zyrvad/digicam/README.md

# Gift cameras (2 units, for friends)

Two DIY retro digital cameras, built as gifts, on shared electronics and firmware:

1. **InstantSnap.novo-style** flat body with a 1.69 in screen. Due 31 Oct 2026 (assumed) and built first.
2. **Yashica Mini Snoopy-style** box with a bigger 2.8 in screen. Follows after; date to confirm.

This is a separate project from `../PLAN.md`. That file (July 2026) plans a screenless, disposable-style camera as a commercial product.

## Files

| File | What it is |
| --- | --- |
| `01-research-brief.md` | First research pass: commercial cameras compared, buy vs build, early hardware ideas |
| `02-build-plan.md` | **The current plan**: decisions, 4-week timeline, parts, wiring and charging, pin plan, firmware spec, case finish, checklists |
| `03-how-it-works.md` | How the firmware and simulator work, step by step |
| `04-case-design.md` | Camera 1 case. **v2 test-fit body (10 Oct)** first: electronics sled, layout, wiring lanes, hardware, assembly, printing, what to measure. Then the v1 concept |
| `08-phone-app-plan.md` | Getting photos onto an iPhone: **Phone mode** (camera Wi-Fi, a photo page in Safari, a free Shortcut for saving many), built 15 Oct. Then the earlier app plan |
| `11-assembly-guide-v3.md` | **Build either v3 body (23 Oct)**, with an interactive 3D version at https://claude.ai/artifact/BogmuenUrWaN1Fk98t3Pgy (`guide-v3/`): tools and parts, heat-set inserts, the wiring diagram (part pin to board pad), wire routes and cut lengths, soldering, ten build steps with pictures, what holds each part, checks and fixes |
| `13-assembly-guide-v4.md` | **Build camera 1 (v4, 24 Oct)**: the retro body rebuilt around the real screen and board, styled after the Leica M6 in brown and in its proportions (128 × 73 × 22 mm, 25 Oct). What to measure before printing, the three Bambu plates (a test-first plate of the inside), screws and inserts, the v4 pin plan and wire lengths, build steps. Model `cad/camera1_v4.scad`, exports `cad/export/v4/` |
| `12-packing-list-retro.md` | **Packing list for building the retro camera (24 Oct)**: what to do before leaving, all 20 printed pieces, electronics, screws and inserts by length, wire/tape/glue, tools, cables, offline guides |
| `10-frame-mailbox.md` | **DigiGallery frame mailbox (22 Oct)**: the phone page picks what Allen's desk frame shows; `/api/frame` on the camera, the document's format, tests |
| `09-phone-ui-design.md` | **Phone page v2 plan (21 Oct)**: design, mockup in `design/phone-v2/`, the home-screen app evaluated, firmware changes it needs |
| `07-shopping-list.md` | What's still to buy to join the parts: battery socket, camera ribbon, wire, inserts, screws, tape, with Lazada search terms |
| `06-assembly-guide.md` | **Step-by-step assembly with a picture per step**, and the link to the interactive 3D guide (`guide/`) |
| `05-bench-bring-up.md` | **Start here with the parts on the desk**: wiring every part to the board, testing the whole pipeline step by step, and removing the pin headers for the case |
| `cad/` | **v4 (24 Oct): `camera1_v4.scad`**, retro only, built around the measured parts (`export_v4.py`, `check_v4.py`, `make_plates_v4.py`, `wiring_v4.py`). Before that, **v3 bodies (23 Oct): `camera1_v3.scad`**, two styles (clear Novo-like and retro rangefinder) for the 2.0 in screen and the camera on the board. Print files in `export/v3/<style>/`, renders in `renders/v3/`, `export_v3.py` rebuilds and runs the fit check `check_v3.py`. Older: v2 (`camera1_v2.scad`, 1.14 in screen), v1 Fusion model |
| `firmware/` | ESP-IDF camera firmware (0.4.3): runs the camera on its own with screen, buttons and battery gauge; preview, photos, video, gallery, settings, film looks, and Phone mode (its own Wi-Fi and photo page) |
| `host/` | Laptop simulator: a virtual camera in the browser driving the real board. Start with `host/run.sh` ([host/README.md](host/README.md)). `host/bench.py`: screenshots of the camera's screen, button presses, status and log from the terminal |
| `diagrams/` | `wiring-bench.png` (every wire, pin to pin; from `wiring_bench.py`), `timeline.png` and `wiring.png` (block diagram; still shows the dial), `wiring-early.png` (first sketch, superseded), rendered from the claude.ai doc |

**These local files are the main copy** (decided 8 Oct 2026). Edit them here. The claude.ai doc https://claude.ai/artifact/KfYH1emPw4jr6YSeR5GVqt is frozen as of 8 Oct and is no longer updated.

## Hardware at a glance

- Board: GOOUUU ESP32-S3-CAM Core N16R8 with OV3660, on a ribbon extension. You own one (camera 1); buy one more (camera 2).
- Screens: 1.69 in ST7789 IPS 240×280 (camera 1); 2.8 in ST7789 IPS 320×240 (camera 2). Controls: rotary dial (EC11), shutter button, slide switch.
- Power: 3.7 V LiPo (camera 1: the 2000 mAh 103450 you own) → USB-C charge + boost module (IP5306 type) → switch → board 5V pin.
- Storage: the board's built-in microSD slot (SDMMC 1-bit, GPIO 38/39/40).
- Firmware: `firmware/` (ESP-IDF v5.5.4); camera and SD code came from Love Letter Box's `firmware/camera-test` (now on its repo's `june-2026` branch). Since 10 Oct the camera runs standalone on the 1.14 in screen; `host/` still works alongside it.
