zyrvad/digicam/cad/art/leather.png

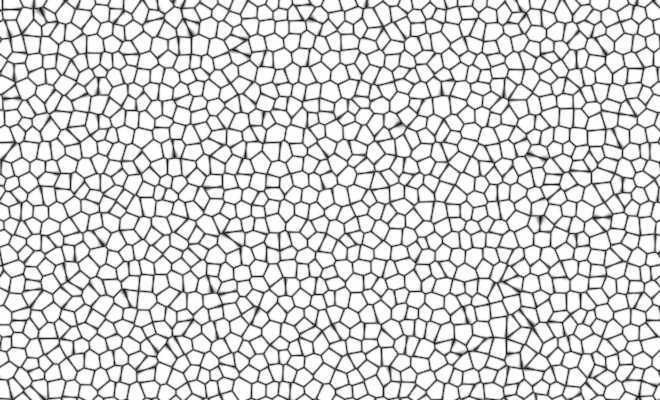
cad/art/leather.png
