zyrvad/digicam/cad/renders/v4/deck_screen_board.png

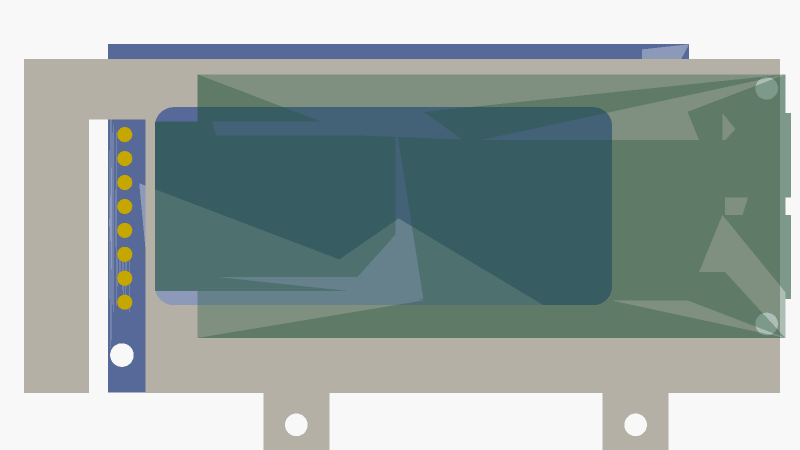
cad/renders/v4/deck_screen_board.png
