zyrvad/digicam/cad/renders/v4/exploded.png

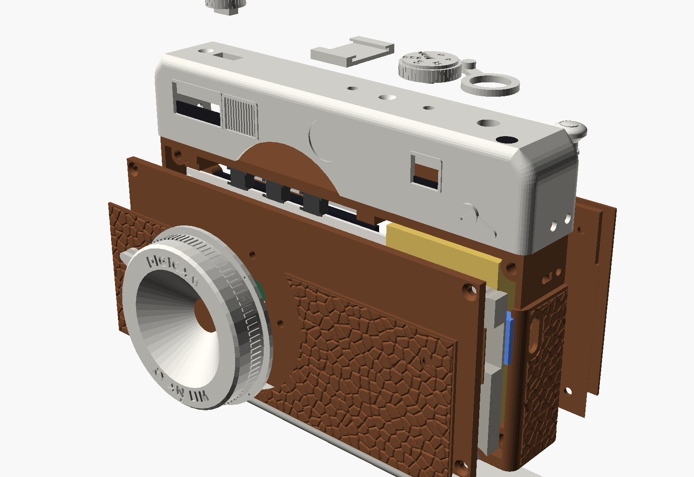
cad/renders/v4/exploded.png
