zyrvad/digicam/cad/renders/v4/front_flat.png

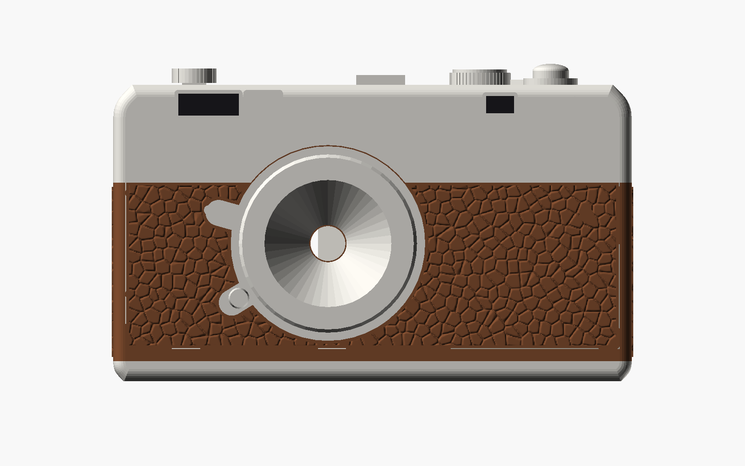
cad/renders/v4/front_flat.png
