zyrvad/digicam/cad/renders/v4/inside.png

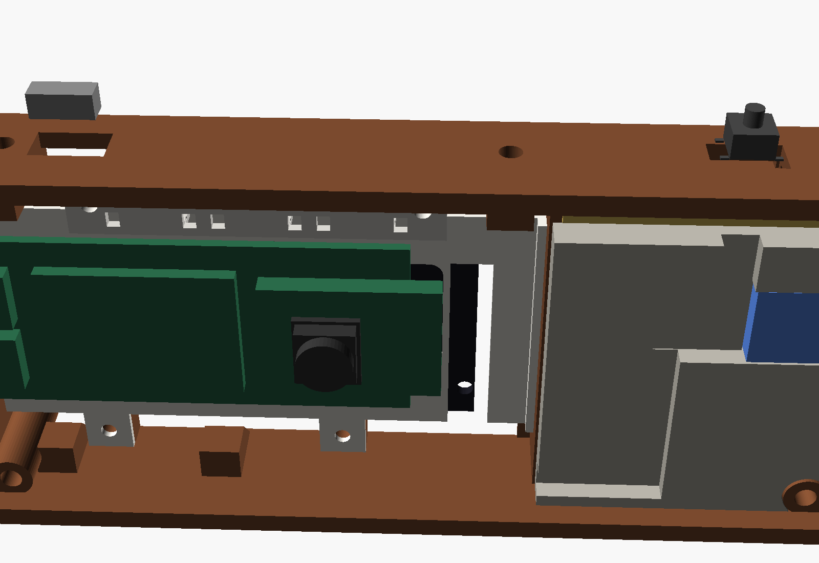
cad/renders/v4/inside.png
