zyrvad/digicam/cad/renders/v4/screen_bevel.png

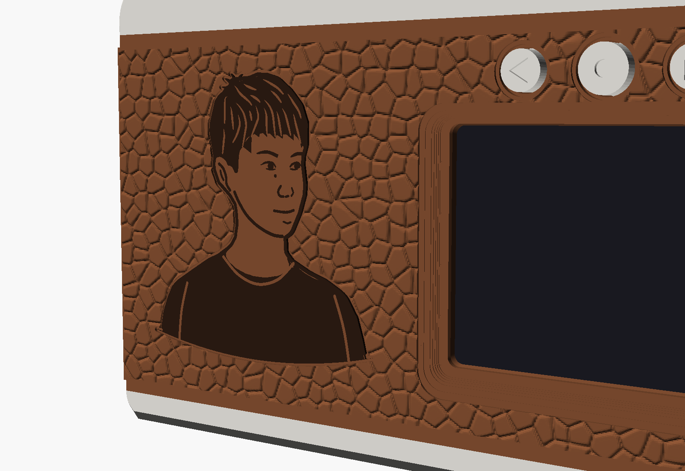
cad/renders/v4/screen_bevel.png
