zyrvad/digicam/cad/renders/v4/top_lefthanded.png

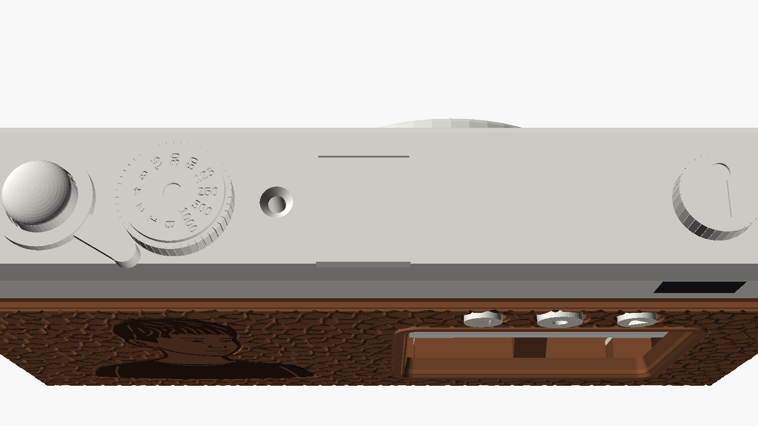
cad/renders/v4/top_lefthanded.png
