zyrvad/digicam/diagrams/stack-v4.png

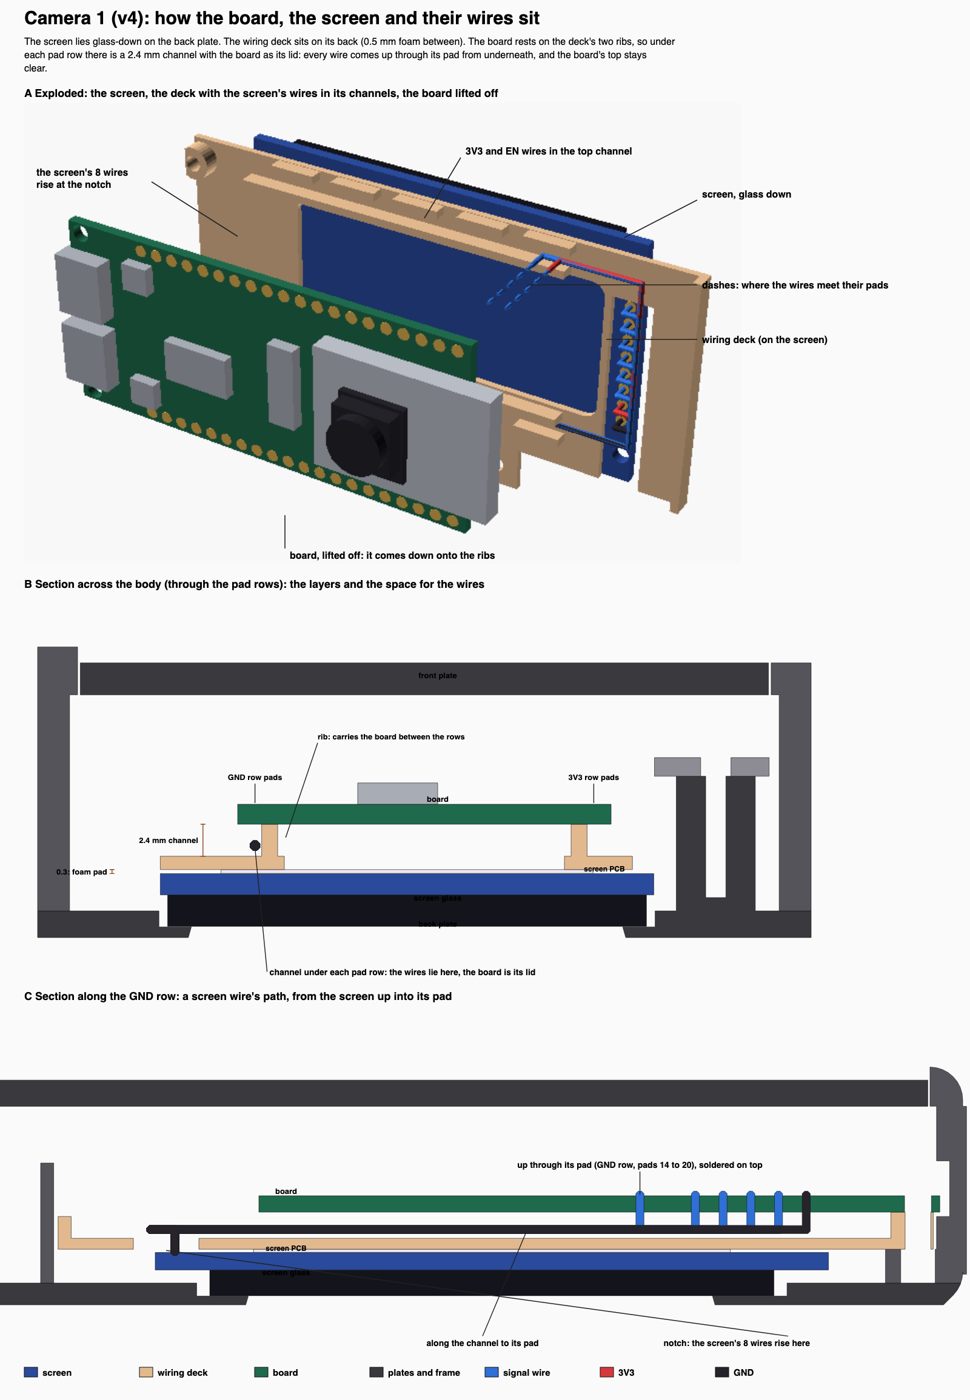
diagrams/stack-v4.png
