zyrvad/digicam/cad/export/v4/back_leatherette.3mf

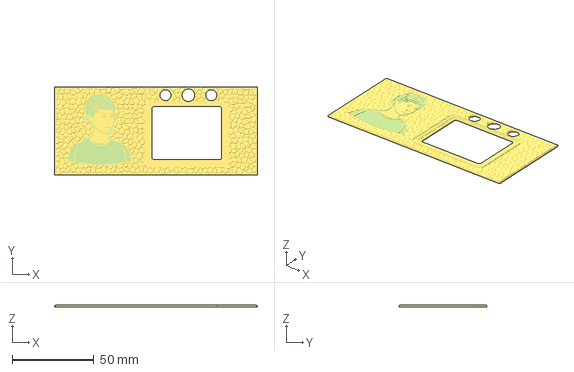
[picture p9: CAD file, 2026-10-27]
cad/export/v4/back_leatherette.3mf
124.0 x 54.0 x 1.40 mm
