zyrvad/digicam/cad/export/v4/frame.3mf

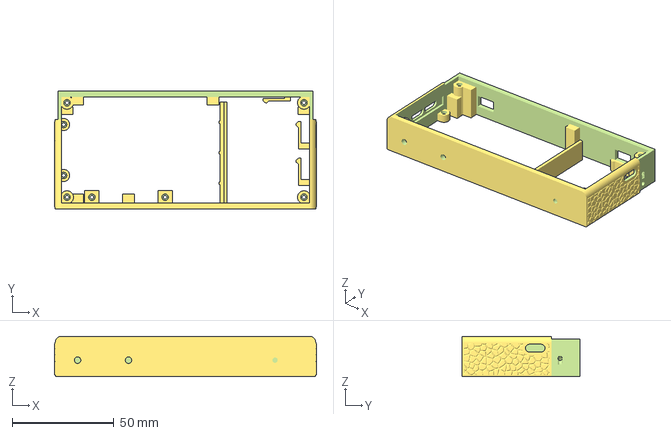
[picture p10: CAD file, 2026-10-27]
cad/export/v4/frame.3mf
128.7 x 58.0 x 19.8 mm
