zyrvad/digicam/cad/export/v4/portrait_inlay.3mf

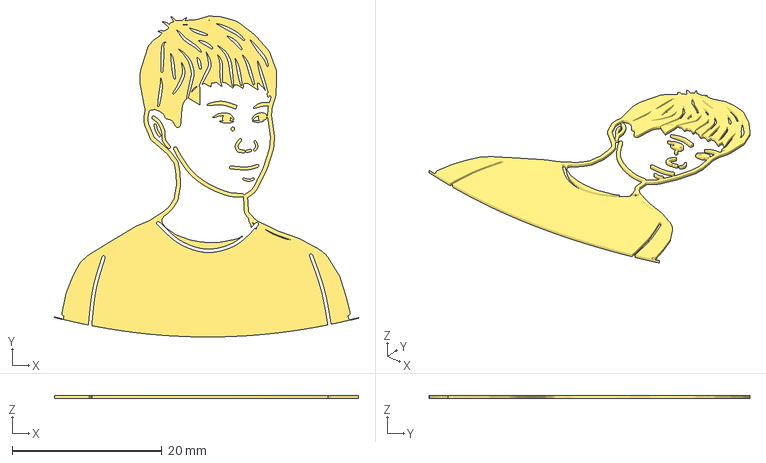
[picture p11: CAD file, 2026-10-27]
cad/export/v4/portrait_inlay.3mf
40.6 x 42.9 x 0.4 mm
