zyrvad/digicam/cad/export/v4/lens_barrel.stl

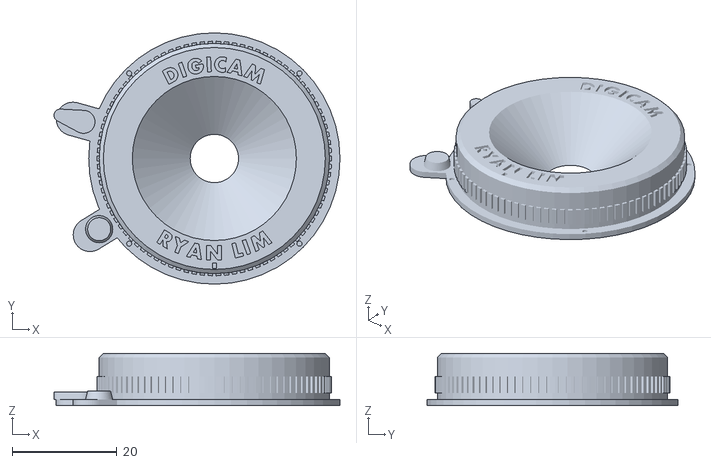
[picture p12: CAD file, 2026-10-27]
cad/export/v4/lens_barrel.stl
54.6 x 48.0 x 9.99
