zyrvad/digicam/cad/export/v4/window_card.stl

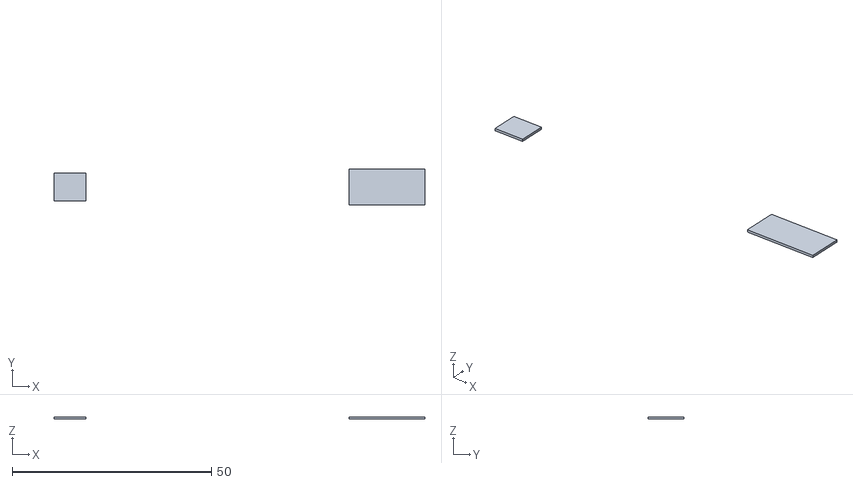
[picture p13: CAD file, 2026-10-27]
cad/export/v4/window_card.stl
93.0 x 9.00 x 0.6
