zyrvad/digicam/cad/export/v4/bottom_plate.stl

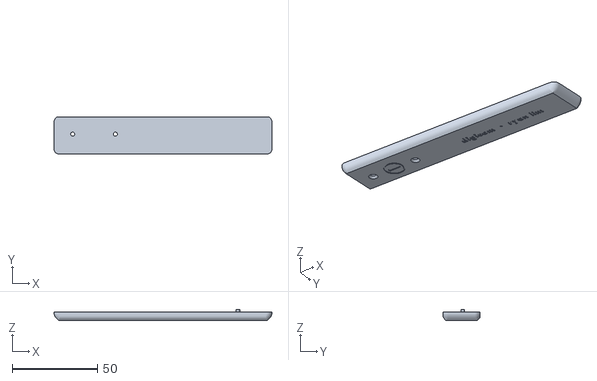
[picture p14: CAD file, 2026-10-27]
cad/export/v4/bottom_plate.stl
128.0 x 21.8 x 6.39
