zyrvad/digicam/cad/export/v4/leatherette.3mf

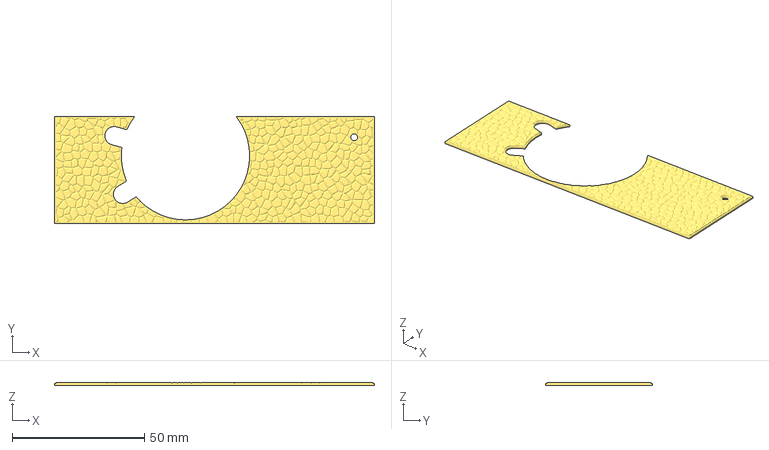
[picture p15: CAD file, 2026-10-27]
cad/export/v4/leatherette.3mf
121.2 x 40.4 x 1.20 mm
