zyrvad/digicam/cad/export/v4/top_bits.stl

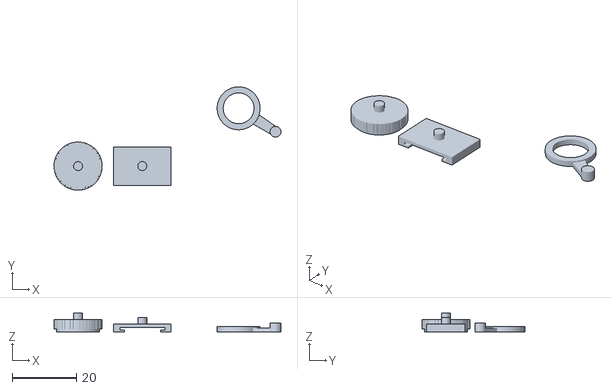
[picture p16: CAD file, 2026-10-27]
cad/export/v4/top_bits.stl
70.7 x 32.2 x 5.80
