zyrvad/digicam/cad/export/v4/top_plate.stl

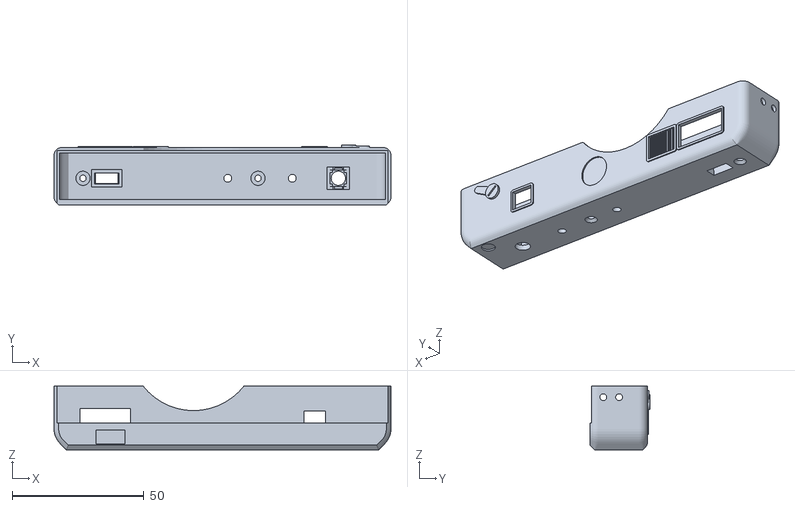
[picture p17: CAD file, 2026-10-27]
cad/export/v4/top_plate.stl
128.0 x 22.7 x 24.2
