zyrvad/digicam/cad/export/v4/back_plate.stl

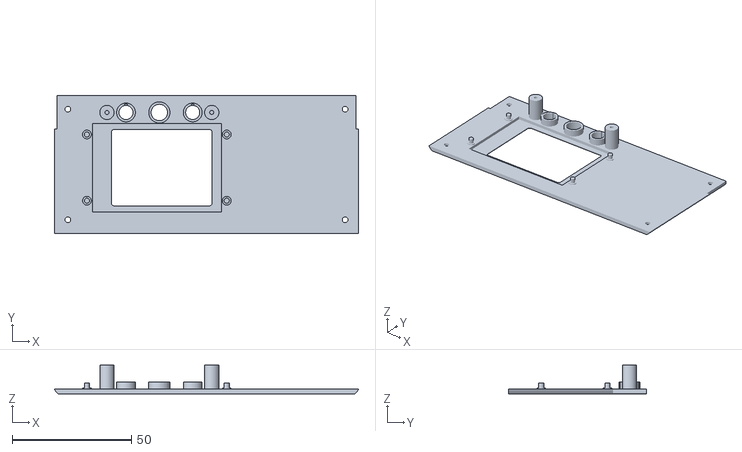
[picture p18: CAD file, 2026-10-25]
cad/export/v4/back_plate.stl
127.6 x 58.0 x 12.1
