zyrvad/digicam/cad/export/v4/carrier.stl

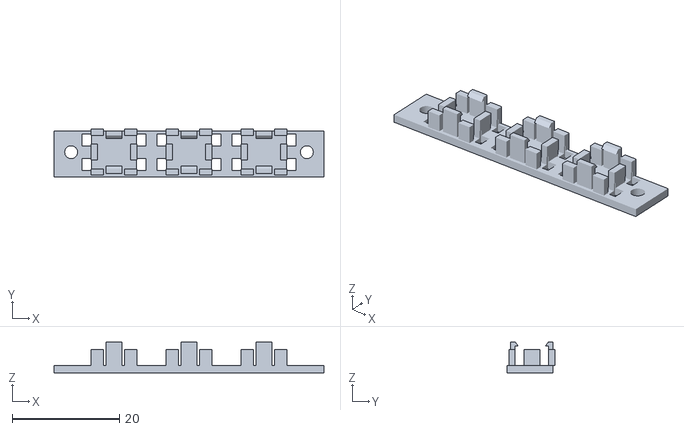
[picture p19: CAD file, 2026-10-25]
cad/export/v4/carrier.stl
50.4 x 8.90 x 5.75
