zyrvad/digicam/cad/export/v4/cradle.stl

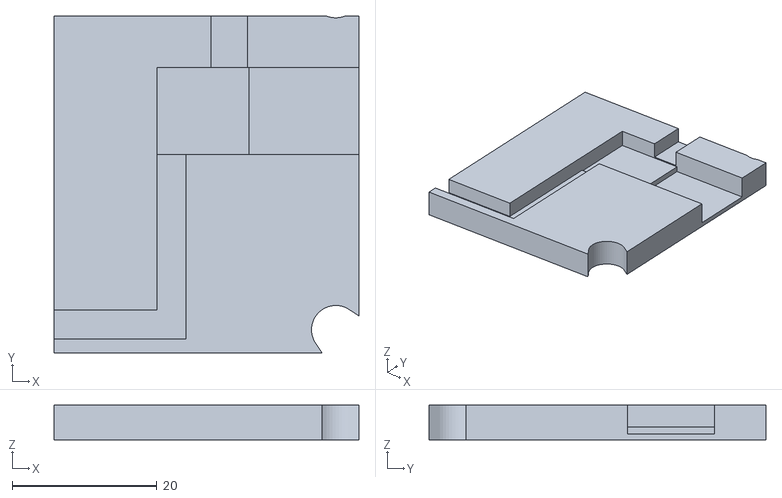
[picture p20: CAD file, 2026-10-25]
cad/export/v4/cradle.stl
42.1 x 46.5 x 4.80
