zyrvad/digicam/cad/export/v4/knob_cap.stl

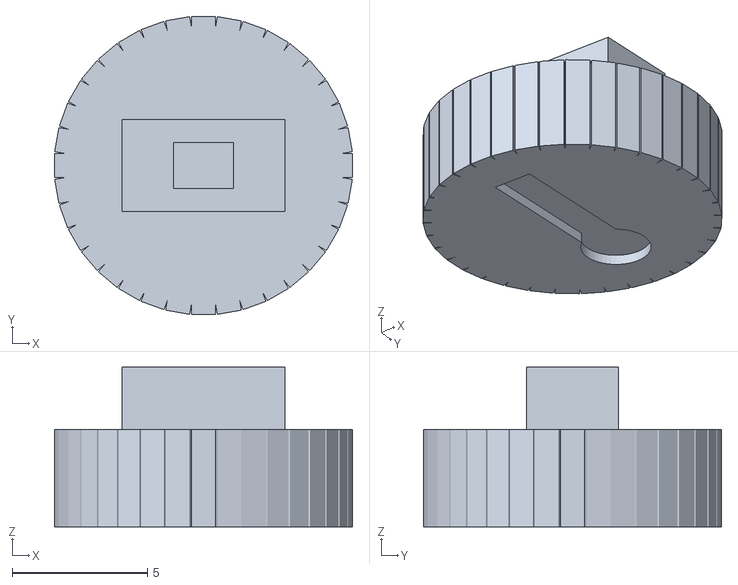
[picture p21: CAD file, 2026-10-25]
cad/export/v4/knob_cap.stl
11.0 x 11.0 x 5.90
