zyrvad/digicam/cad/export/v4/caps_light.stl

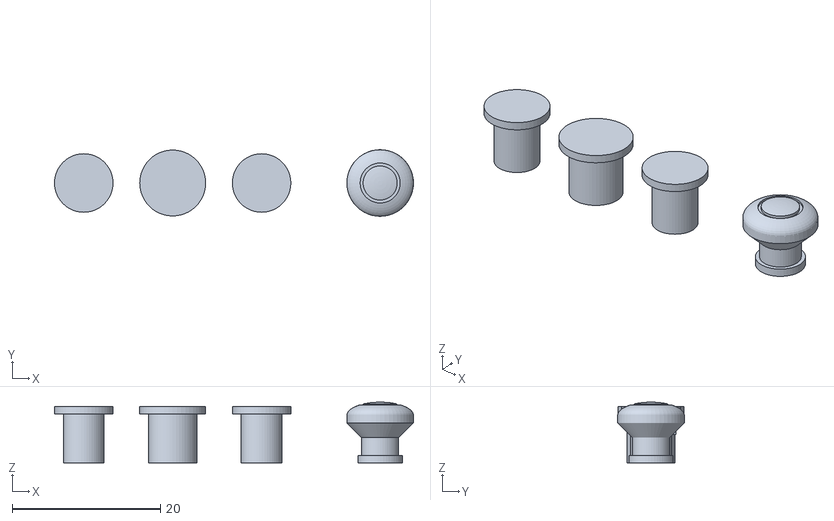
[picture p22: CAD file, 2026-10-25]
cad/export/v4/caps_light.stl
48.5 x 9.00 x 8.20
