zyrvad/digicam/cad/export/v4/deck.stl

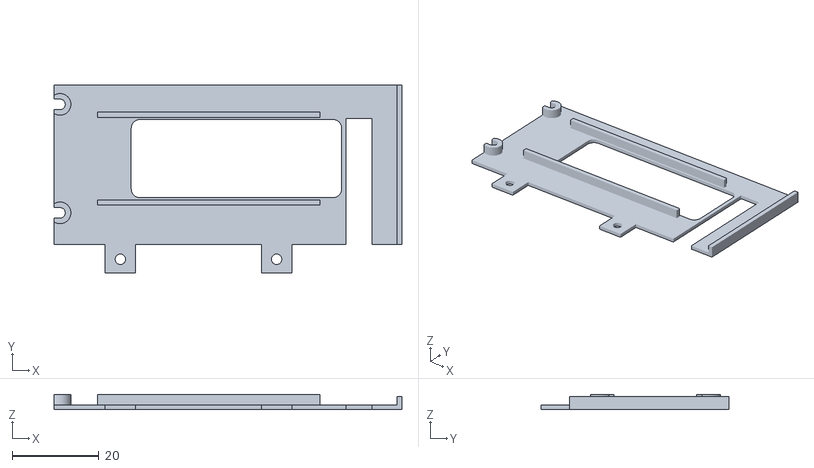
[picture p23: CAD file, 2026-10-25]
cad/export/v4/deck.stl
80.2 x 43.4 x 3.40
