zyrvad/digicam/cad/export/v4/front_plate.stl

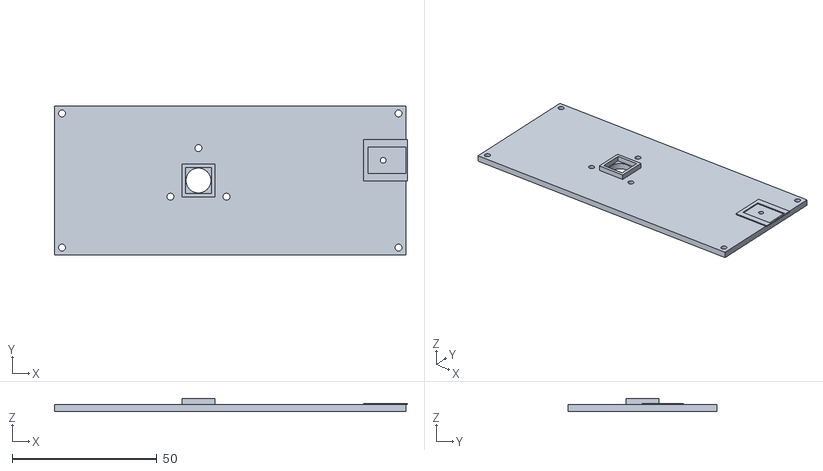
[picture p24: CAD file, 2026-10-25]
cad/export/v4/front_plate.stl
122.1 x 51.6 x 4.40
