zyrvad/digicam/cad/export/v3/retro/button_caps.3mf

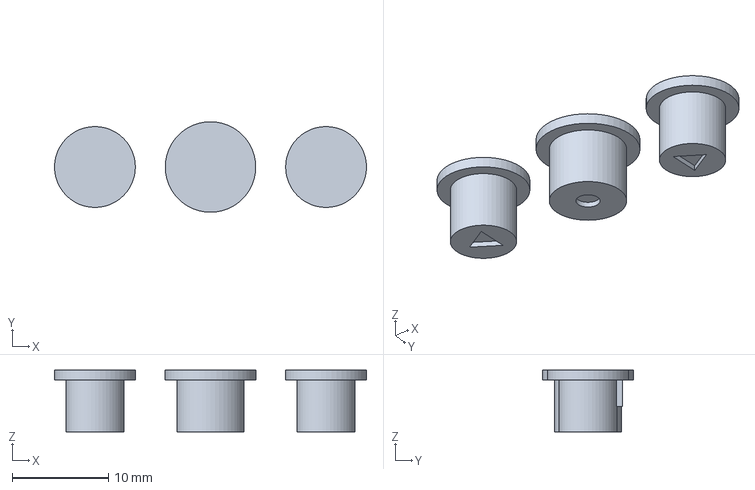
[picture p25: CAD file, 2026-10-24, an earlier design]
cad/export/v3/retro/button_caps.3mf
32.4 x 9.40 x 6.39 mm
