zyrvad/digicam/(list of files, cad)

Other CAD files:
cad/export/v4/camera1_v4_plates.3mf
cad/camera1_v3.scad
cad/export/v3/retro/button_caps.stl
cad/export/v3/retro/carrier_4leg.3mf
cad/export/v3/retro/carrier_4leg.stl
