zyrvad/digicam/guide-v4/portrait.png

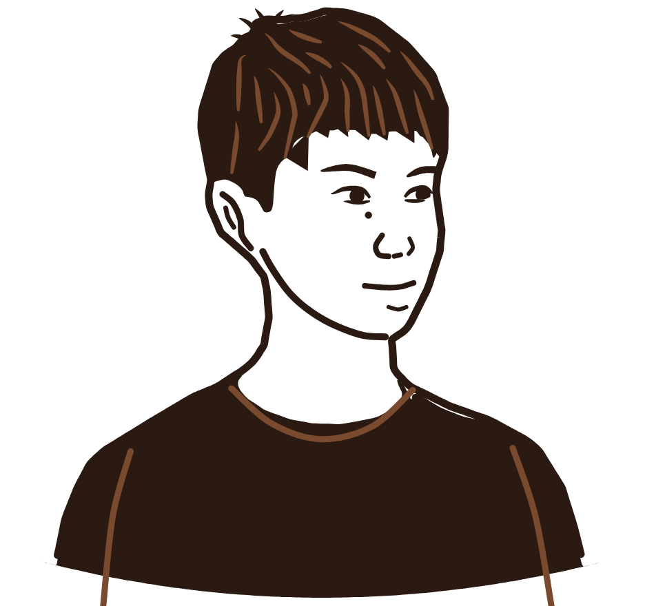
guide-v4/portrait.png
