zyrvad/digicam/(commit log)

2026-10-25 Case v4: the retro body rebuilt round the real parts, as a left-handed Leica M6 in brown
    - camera1_v4.scad: 128 x 73 x 22 mm, the M6's proportions; silver cover down to a third of the
    height, silver bottom plate, brown body with leather front, back and ends; controls on the left
    for a left-handed user; 44 mm lens with its mount ring, release and selector; RYAN / LIM in Futura
    - inside: screen turned (pins by the board's module end) and sunk in a pocket, its pins 27.8 mm
    apart; wiring deck with open lanes for 26 AWG and a wire tray, 1 mm higher on its bosses; the
    board's two USB-C openings; battery held by spring tabs; the power cradle as a located block with
    wire grooves; Allen's f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
    [back_leatherette.3mf, back_plate.stl, bottom_plate.stl, camera1_v4.scad, camera1_v4_plates.3mf, caps_light.stl, carrier.stl, cradle.stl]
2026-10-25 Case v4: button carrier wire holes 1.8 x 2.25 mm for 26 AWG, buttons 14 mm apart; a button test plate
    [back_leatherette.3mf, back_plate.stl, camera1_v4.scad, camera1_v4_plates.3mf, carrier.stl, frame.3mf, leatherette.3mf, portrait_inlay.3mf]
2026-10-25 Case v4: two overnight plates of low-risk parts (silver: bottom plate, lens, caps, dial, shoe, lever; brown: the front covering)
    [camera1_v4_plates.3mf]
2026-10-26 Case v4: final plates 1-4 (body, silver at 0.12 mm, front covering, back covering) with the tuned flow ratios, scarf seams and slower outer walls; test plates kept as 5-10
    [back_leatherette.3mf, camera1_v4_plates.3mf, frame.3mf, leatherette.3mf, portrait_inlay.3mf]
2026-10-26 Plates: keep Bambu's preset names with the tuned flow ratios as edits, so Bambu Studio opens the project
    [camera1_v4_plates.3mf]
2026-10-27 Case v4: thicker frame divider (1.6 mm, foot and gussets) and spring tabs (1.3 mm) for wood PLA; solid back and front plates, no scarf seam on the body plate
    [back_leatherette.3mf, camera1_v4.scad, camera1_v4_plates.3mf, frame.3mf, leatherette.3mf, portrait_inlay.3mf]
2026-10-27 Case v4: silver front with no lettering (name on the lens only, bold), bigger windows centred on the band with black window glasses, plain red-dot recess; plate 11: plate 1 in PLA Matte black with th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
    [back_leatherette.3mf, bottom_plate.stl, camera1_v4.scad, camera1_v4_plates.3mf, frame.3mf, leatherette.3mf, lens_barrel.stl, portrait_inlay.3mf]
